VoyteckPL/gas-meter-arduino/gas_meter_app/README.md

# Energia Gazomierz (aplikacja / dodatek Home Assistant)

Panel w pasku bocznym dla gazomierza na baterii (ESP32): odczyty, historia, bateria z prognozą żywotności,
powiadomienia, ustawienia i tryb serwisowy. Rozmawia z gazomierzem przez MQTT.

Instalacja i opis w `DOCS.md`.
