VoyteckPL/gas-meter-arduino/docs/images/ha-panel-mockup.png

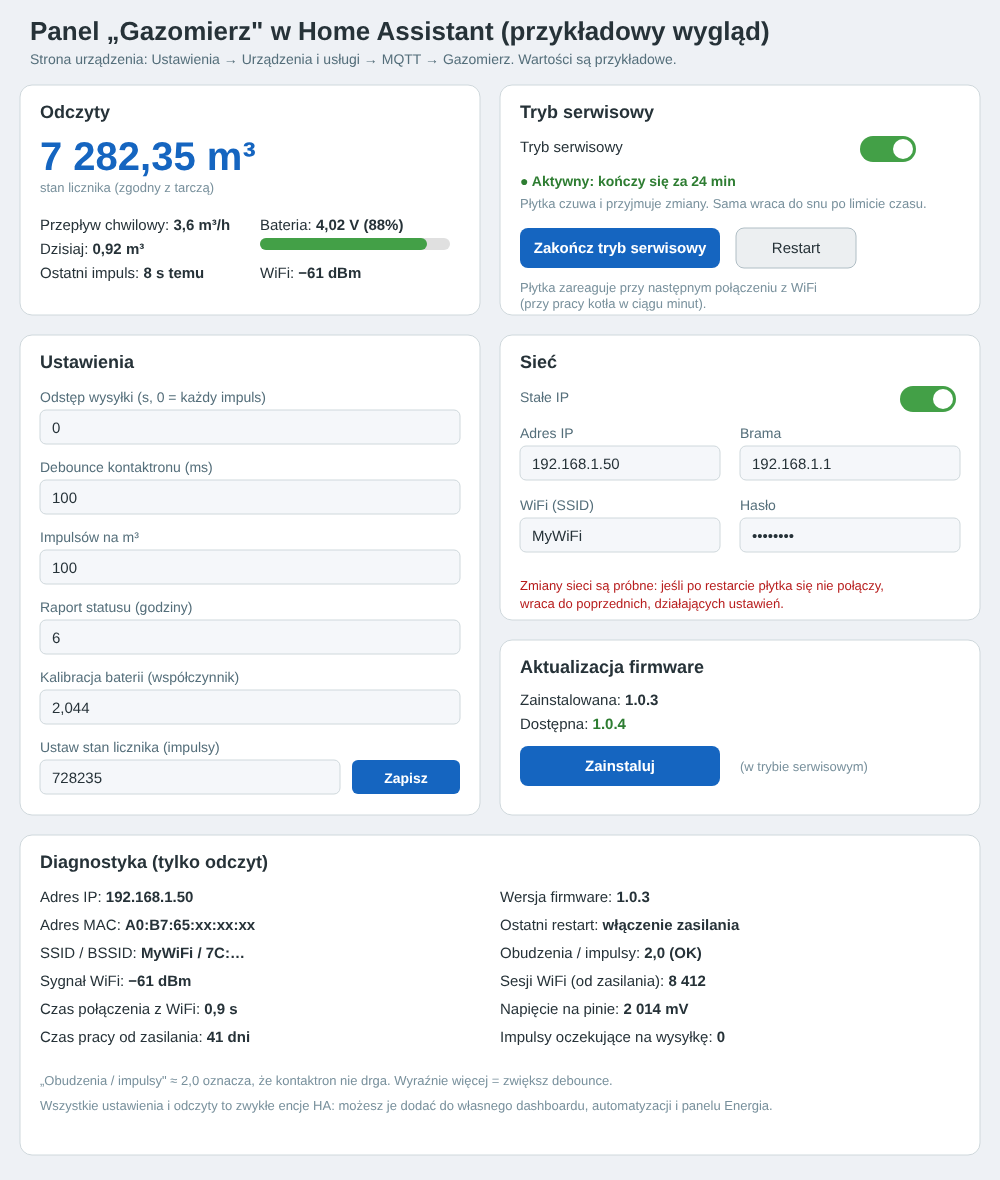
docs/images/ha-panel-mockup.png
