VoyteckPL/gas-meter-arduino/docs/images/reed-pullup.png

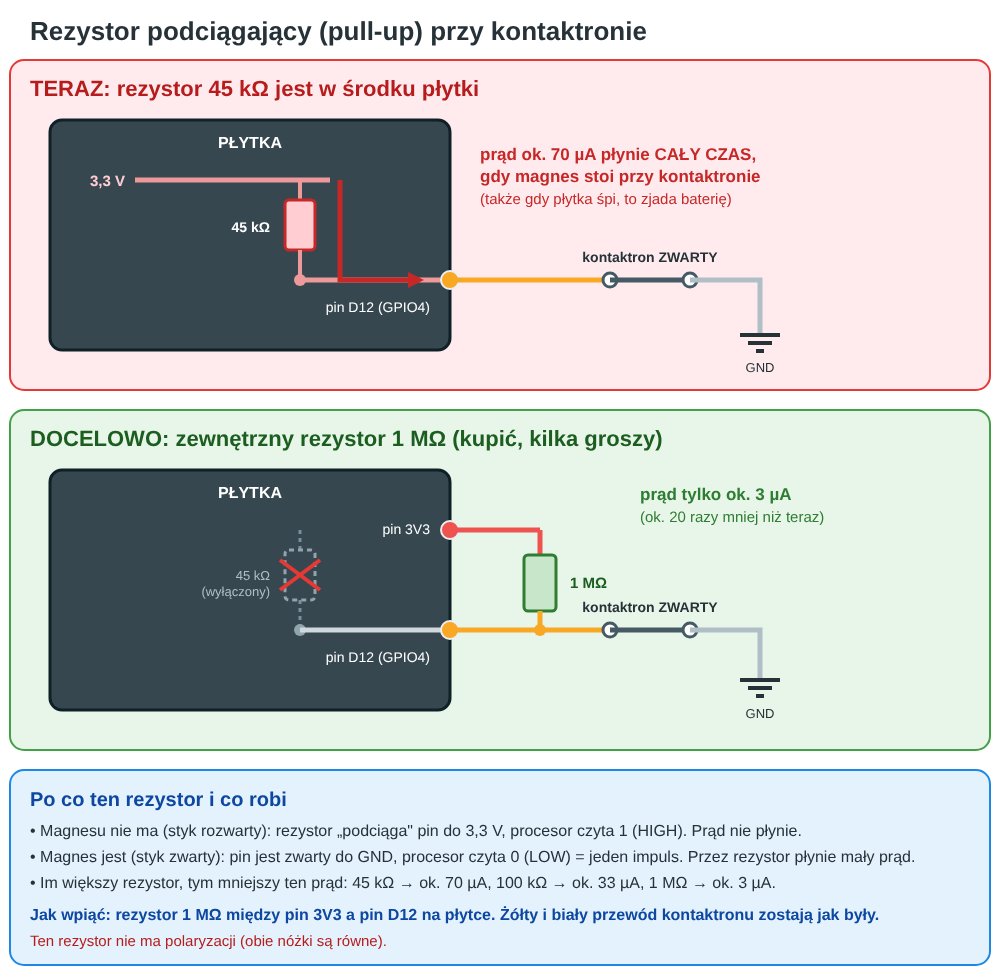
docs/images/reed-pullup.png
