VoyteckPL/gas-meter-arduino/docs/images/wiring-wago.png

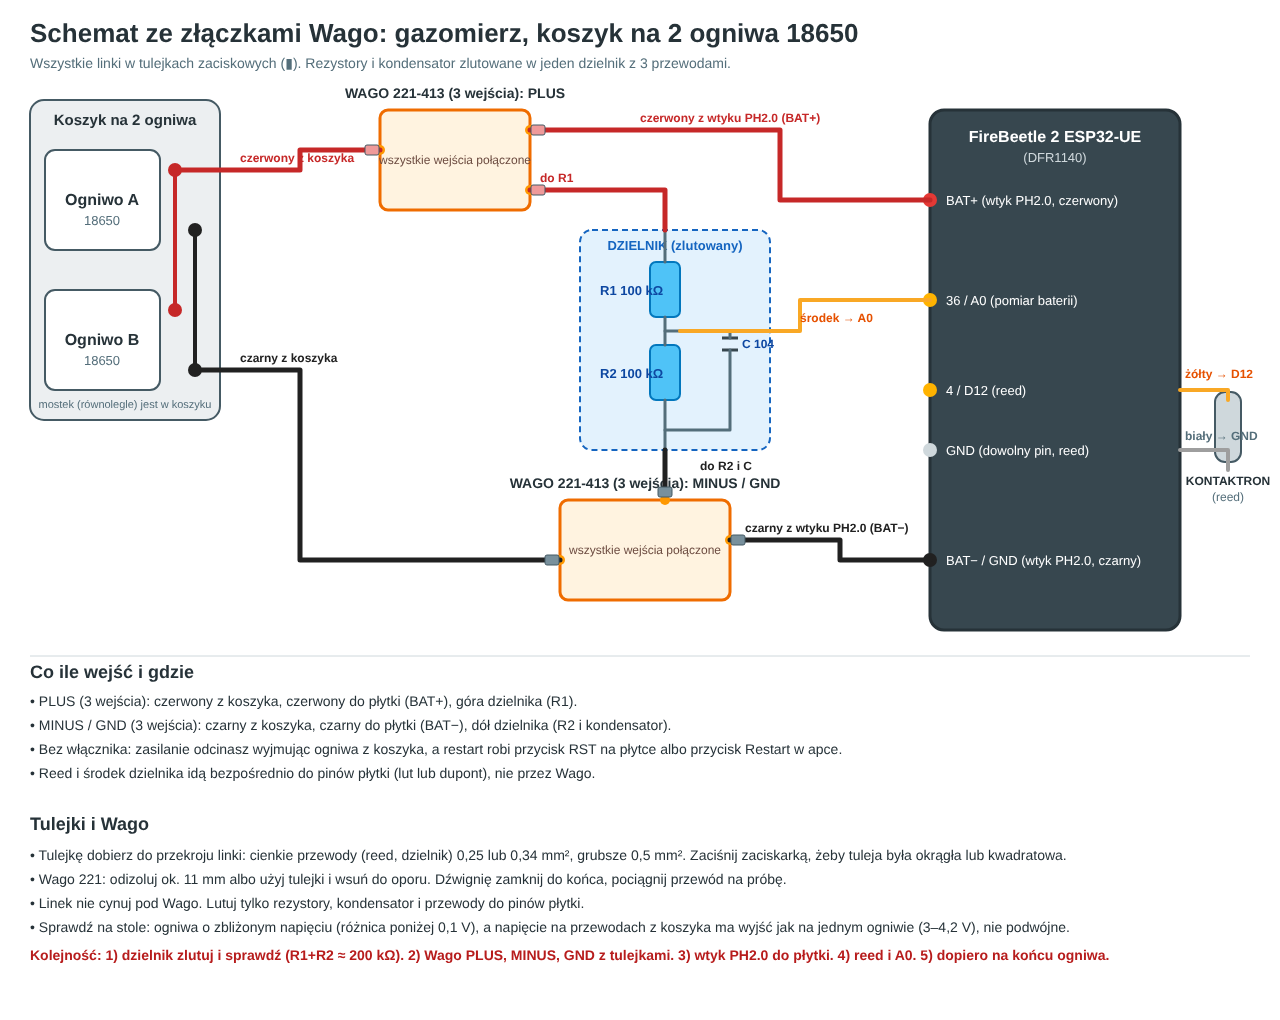
docs/images/wiring-wago.png
