VoyteckPL/gas-meter-arduino/docs/images/wiring.png

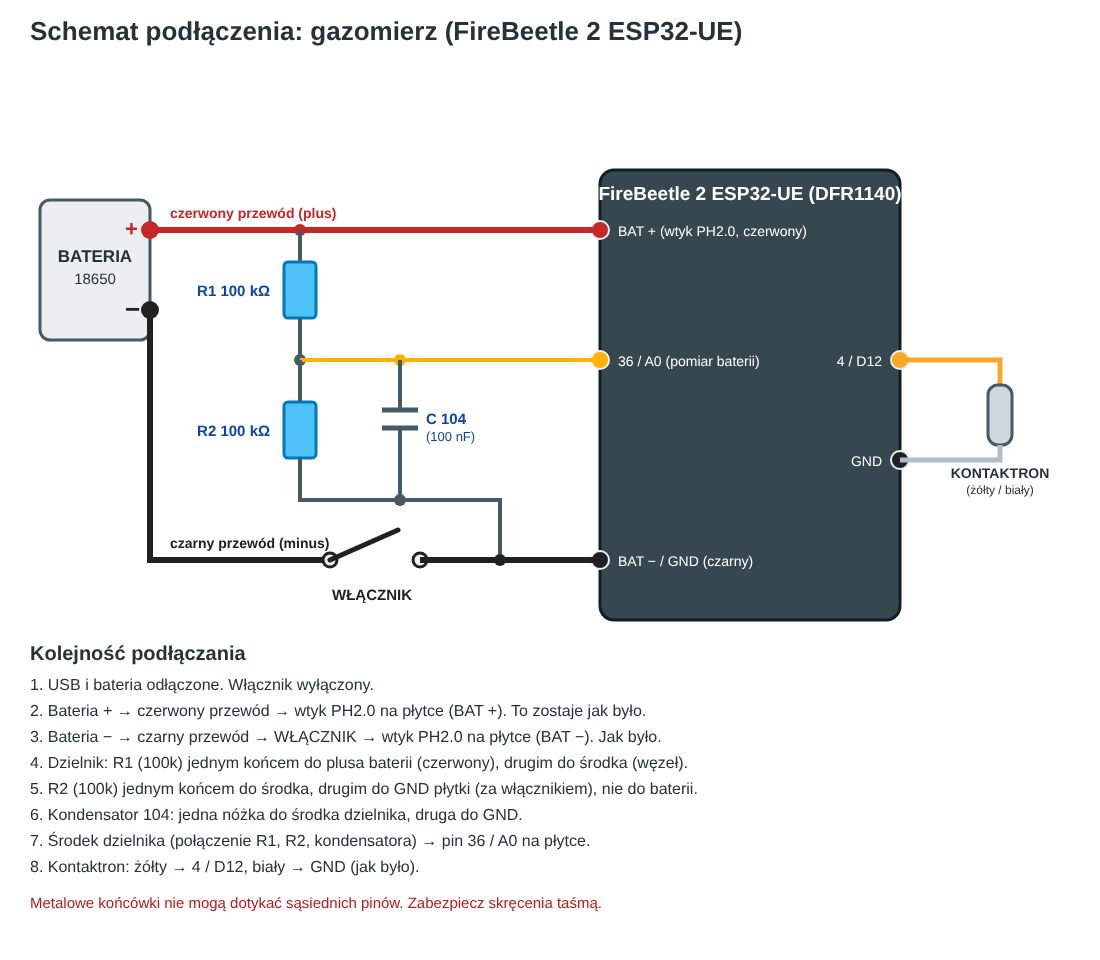
docs/images/wiring.png
