VoyteckPL/gas-meter-arduino/gas_meter_app/CHANGELOG.md

# Changelog

## 0.48.1

* Import statystyk gazu i kosztów (`recorder/import_statistics`) wysyła teraz `mean_type` i `unit_class`. Bez tego HA Core 2026.11 przestaje przyjmować takie importy (historia gazu, podział CWU/ogrzewanie, koszty), a ostrzeżenie w logu HA znika.

## 0.48.0

* Licznik od wymiany baterii. Domyślna data to 29.10.2026 16:40 (opcja „Data wymiany baterii”), zmienisz ją też w zakładce Bateria (data i przycisk „Wymieniłem teraz”).
* Przegląd: nowy kafelek „Od wymiany”: dni pracy, zużycie z ogniw (%) i gaz od wymiany.
* Zakładka Bateria: karta „Od wymiany baterii” z datą włożenia, dniami, energią z ogniw (mAh i %, model z czasu pracy gazomierza), gazem w m³ i impulsach, sesjami WiFi i napięciem na starcie oraz teraz.

## 0.47.3

* Kolory pracy pieca są takie same wszędzie: plakietka stanu, historia „Piec” i tarcza ogrzewania mają teraz kolory z wykresu (ogrzewanie czerwono-pomarańczowe, ciepła woda niebieska, wybieg pompy jasnopomarańczowy).

## 0.47.2

* Wykresy gazu: wybieg pompy jest jasnym, żółtawo-pomarańczowym pasem (ogrzewanie zostaje czerwono-pomarańczowe, ciepła woda niebieska).

## 0.47.1

* Zakładka Piec: gdy termostat ogrzewania zgłasza stan „chłodzi” (cooling) albo „circulating”, to jest wybieg pompy. Tarcza robi się fioletowa, z ikoną pompy, pigułką „Wybieg pompy” i opisem, że piec nie spala gazu. Wcześniej wyglądała jak zwykłe ogrzewanie albo pokazywała „Chłodzi”.

## 0.47.0

* Wykresy: wartość pod palcem (data i stan) pokazuje się w linii legendy nad wykresem, a nie w białym dymku nad danymi. Wykres nic już nie zasłania. Wykresy bez legendy zostają przy dymku.

## 0.46.3

* Wykresy gazu: wyraźniejsze kolory pracy pieca (mocniejsze pasy i gruby pasek u dołu). Wybieg pompy ma własny fioletowy kolor i pozycję w legendzie, zamiast szarego „Inne”.

## 0.46.2

* Wykresy: dymek ze stanem trafia do tej połowy wykresu, w której nie ma linii (odczyt wysoko: dymek na dole, i odwrotnie), więc nie zasłania danych. Jest też lekko przezroczysty.

## 0.46.1

* Wykresy przy dużym powiększeniu: linia sprzed widocznego fragmentu nie jest już ucinana u dołu (oś Y obejmuje poziom, z którym linia wchodzi w widok), etykiety osi z długimi liczbami (7301.485) mają tyle miejsca, ile potrzebują, a dymek na wykresie licznika pokazuje stan w miejscu palca, zamiast skakać do odczytu poza widokiem.

## 0.46.0

* Obsługa firmware 0.4.7: impulsy, które dotarły razem po nieudanej sesji, trafiają na wykres w momentach, w których je policzono (gazomierz wysyła, ile sekund temu był każdy z nich). Koniec ze skokami o kilka impulsów.
* Nowa encja diagnostyczna „Sesje uratowane drugą próbą” (retry_ok); w zakładce Sieć przy nieudanych sesjach i w eksporcie diagnostyki.

## 0.45.1

* Poprawka: przesuwanie i powiększanie wykresów przestawało działać, gdy zgubił się koniec jednego dotyku (np. apka przeszła w tło albo dopiero się uruchamiała). Wykres pamiętał „zawieszony” palec i każdy kolejny dotyk brał za szczypanie. Teraz pierwszy palec zawsze zaczyna od czysta, a po powrocie do apki wszystkie gesty są czyszczone.
* Przesuwanie zakładek palcem: niedokończony gest jest zapominany po powrocie do apki, a ukryte okno nie blokuje przesuwania. Po powrocie do apki strona nie zostaje też zablokowana bez przewijania ani w połowie animacji zakładki.

## 0.45.0

* Przegląd: nowy kafelek „Na zewnątrz” obok „Ostatni odczyt”: temperatura na zewnątrz i pogoda (pochmurno, deszcz…) z Home Assistanta, kolor zależny od temperatury. Źródło w nowej opcji „Temperatura na zewnątrz” (czujnik albo encja pogody); puste = pierwsza encja pogody z HA.

## 0.44.3

* Historia pieca na Przeglądzie ma krótki tytuł „Piec”.

## 0.44.2

* Szczegóły termostatu: okresy grzania, zapłony, gaz i koszt liczone ze stanu pieca (tak jak historia na Przeglądzie), a nie z „hvac_action” termostatu, które w Ariston nie pokrywa się z pracą palnika (stąd 0,00 m³ na nagrzanie). Temperatury dalej z termostatu. Gdy historia stanu pieca jest krótsza niż wybrany zakres, kafelek mówi, od kiedy są dane.

## 0.44.1

* Poprawka: od 0.42.1 wykres licznika na Przeglądzie nie rysował się przy pierwszym otwarciu apki (brakujące tłumaczenie zakładki „Piec” przerywało budowanie strony). Brak tłumaczenia nie zatrzymuje już strony, a błąd odświeżania trafia do konsoli przeglądarki.

## 0.44.0

* Zakładka Piec: stuknięcie w tarczę otwiera szczegóły termostatu (24 godz., 7 dni, 30 dni) z historii Home Assistanta:
  * wykres temperatury zmierzonej i ustawionej, z pasami pokazującymi, kiedy palnik grzał;
  * podsumowanie: ile palnik pracował, ile zapłonów, ile gazu i ile zł (z gazomierza);
  * ciepła woda: średnie nagrzanie zasobnika (czas, o ile stopni, m³ i zł) i jak szybko woda stygnie bez grzania;
  * ogrzewanie: taktowanie (krótkie zapłony poniżej 2 min) i średni czas grzania;
  * szybkie nastawy jednym stuknięciem (19–23° dla ogrzewania, 45–60° dla wody).

## 0.43.1

* Zakładka Piec: ciepła woda rozpoznawana także wtedy, gdy jest encją climate (jak w Ariston): po nazwie albo po zakresie temperatur od ok. 30°. Ogrzewanie zawsze na górze, ciepła woda pod nim, w swoich kolorach i z przyciskami „Włączona / Wyłączona”.

## 0.43.0

* Zakładka Piec w nowym wyglądzie. Ogrzewanie ma zawsze ciepłe kolory (pomarańcz → czerwień), ciepła woda zimne (turkus → błękit), niezależnie od tego, co piec robi.
* Każda tarcza ma nagłówek z ikoną, stan w pigułce (Grzeje, Bezczynny, Wybieg pompy, Wyłączone; świecąca kropka, gdy piec pracuje), łuk z gradientem i podziałką, dużą zmierzoną temperaturę i „cel” pod spodem. Tryb przełącza się przyciskiem z napisami (Grzanie / Wyłączone, Włączona / Wyłączona). Wyłączona tarcza szarzeje.

## 0.42.1

* Sterowanie piecem w osobnej zakładce „Piec” (zaraz po Przeglądzie), tarcze jedna pod drugą. Gdy apka nie znajdzie termostatów, zakładka mówi, co wpisać w opcjach.

## 0.42.0

* Nowa karta „Sterowanie piecem” na Przeglądzie: tarcze ogrzewania i ciepłej wody jak w HA Views. Widać zmierzoną i ustawioną temperaturę, co robi piec (grzeje, bezczynny, wybieg pompy, wyłączony) i ciśnienie. Przyciski −/+ zmieniają temperaturę (wysyłana po chwili, gdy przestaniesz klikać), przyciski trybu włączają i wyłączają (wyłączenie z potwierdzeniem).
* Termostaty apka znajduje sama na urządzeniu encji stanu pieca (climate i water_heater, plus czujnik ciśnienia w barach). Można je wskazać ręcznie w nowej opcji „Termostaty pieca”.

## 0.41.1

* Historia pieca odświeża się na żywo razem z wykresem (co 10 s zamiast co minutę).

## 0.41.0

* Historia pieca w czterech widokach do wyboru (zapamiętywany w przeglądarce): Oś czasu, Godziny, Sesje, Tory. Wszystkie mają jedną kolumnę, najnowsze na górze.
* Krótkie zapłony z wybiegiem pompy (mniej niż 5 min przerwy) łączą się w jedną sesję; seria krótkich zapłonów jest opisana jako „taktowanie”.
* Łączny koszt obok tytułu karty (chowany przyciskiem „zł”).

## 0.40.1

* Stan pieca przy wykresie zmienia się w ciągu kilku sekund (apka pyta HA co 3 s zamiast co 20 s), bez odświeżania strony. Historia pieca przeładowuje się sama przy zmianie trybu.

## 0.40.0

* Koszt na wykresach, wyłączany przyciskiem „zł” (zapamiętywany w przeglądarce): na wykresie licznika pod każdym grzaniem i ciepłą wodą jego koszt oraz linijka „w widoku … m³ · … zł”; w oknie historii stanu licznika te same kwoty i wiersz „Koszt gazu”; w historii pieca kwoty i suma.
* Historia pieca ułożona: każde uruchomienie w równym wierszu z kolumnami (godziny, czas, m³, zł), lista idzie po kolei w dół. Podsumowania trybów w równej siatce.
* Wybieg pompy bez m³ i zł (pompa nie spala gazu; to była końcówka poprzedniego grzania).

## 0.39.0

* Nowa karta „Piec: co chodziło” na Przeglądzie (dziś, 24 godz., 7 dni): każde uruchomienie pieca jako plakietka z godzinami, czasem, zużytymi m³ i kosztem w zł. Na górze podsumowanie każdego trybu i łączna kwota, pod nim pasek czasu.
* Koszt liczony samą ceną gazu z faktur (zł/kWh × kWh/m³), bez opłat stałych, bo te płaci się i tak.
* Kliknięcie plakietki stanu pieca przy wykresie przewija do historii.

## 0.38.2

* Stan pieca: „circulating” to wybieg pompy, z ikoną pompy.

## 0.38.1

* Wykres licznika: bez stanu licznika przy kropce „teraz” (jest w pasku odczytów).
* Obok tytułu wykresu: co teraz robi piec (Ogrzewanie, Ciepła woda, Wybieg pompy, spoczynek), od kiedy i jak długo. Stan „cooling” z encji HVAC jest pokazywany jako wybieg pompy. Ikona świeci, gdy piec pracuje.

## 0.38.0

* Bateria, Sieć i OTA w nowym stylu: u góry pasek kafelków, niżej karty na całą szerokość, szczegóły i ustawienia zwinięte na dole.
* Bateria: kafelki naładowanie, pojemność, wystarczy na, naładuj do, średni prąd, sesje WiFi na dobę. Prognoza żywotności i tabela miesięcy obok siebie, „Na co idzie energia” obok „A gdyby…”. Statystyki dla nerdów i powiadomienia zwinięte. Dane testu rozładowania są w karcie wykresu.
* Sieć: sygnał, czas łączenia, nieudane sesje (z odsetkiem), adres IP, punkt dostępu i MAC.
* OTA: firmware, czas pracy, impulsy i obudzenia na górze; ustawianie stanu licznika i diagnostyka zwinięte.

## 0.37.0

* Zakładka Zużycie uporządkowana: u góry pasek odczytów jak na Przeglądzie (zużycie, koszty, prognoza), niżej wykresy na całą szerokość, bez pustych miejsc.
* Usunięte: tabela prognozy na 6 miesięcy, wykres „im zimniej, tym więcej gazu” i tabela „Czy dom jest oszczędniejszy?”. Krótsze opisy przy wykresach.
* „Rocznie” jest teraz w karcie „Porównanie lat”, a profil sezonowy w dwóch kolumnach.
* Faktury z eBOK, Orlen, Panel Energia (koszty wstecz i podział pieca) i lokalizacja pogody są zwinięte na dole w sekcji „Dane i ustawienia”.
* Karta pieca znika, gdy nie ma ustawionej encji pieca.

## 0.36.0

* Nowy pasek odczytów na Przeglądzie: wszystko w jednym rzędzie, w dwóch grupach (gaz | gazomierz), z większymi ikonami.
* Nowy kafelek „Ostatni pobór”: kiedy gaz ostatnio płynął (ostatni przyrost licznika). „Ostatni odczyt” to osobno ostatnie dane z gazomierza.
* Kolory mówią o stanie: przepływ pulsuje, gdy gaz płynie; bateria, sygnał WiFi i świeżość odczytu zmieniają kolor przy problemie.
* Usunięta podpowiedź „Kliknij wartość…” (kafelki nadal otwierają historię).

## 0.35.6

* Wykres licznika nie znika już („Brak danych”) po dłuższej nieaktywności apki. Gdy telefon uśpił stronę i zapytanie o dane przepadło, wykres zostaje ostatni znany, a po powrocie do apki odświeża się od razu.

## 0.35.5

* Zakładka OTA: przycisk „Pobierz diagnostykę połączenia”. Plik JSON z ostatnich 48 godzin: nieudane sesje wg etapu, sesje WiFi, czasy, sygnał, stan i przyrosty na godzinę z odsetkiem porażek. Apka zapisuje teraz historię także dla liczników nieudanych sesji (wcześniej tylko HA).

## 0.35.4

* Nowe encje diagnostyczne (firmware 0.4.5): Nieudane sesje – WiFi, połączenie z brokerem, subskrypcja, brak potwierdzenia. Pokazują, na którym etapie zawodzą sesje licznika.

## 0.35.3

* Koszty wstecz: gdy HA po zaimportowanych godzinach zaczął sumę kosztu od zera (panel pokazywał ujemny koszt), przycisk wykrywa spadek sumy i podnosi resztę statystyki o brakującą wartość.

## 0.35.2

* Koszty wstecz działają też, gdy HA nie zapisał jeszcze żadnej godziny kosztu: historia jest wpisywana do ostatniej pełnej godziny.

## 0.35.1

* Koszty wstecz: encja kosztu jest brana z informacji panelu Energia (`energy/info`), a nie zgadywana po nazwie.

## 0.35.0

* Koszty gazu wstecz w panelu Energia (zakładka Zużycie → „Koszty w panelu Energia (wstecz)”). Każda godzina historii przed ustawieniem ceny dostaje zużycie × cena z faktury z tego miesiąca i trafia do tej samej statystyki kosztu, którą HA prowadzi dla Gazomierza; późniejsze godziny są przesunięte o dopisaną sumę, więc suma jest ciągła. „Sprawdź” tylko liczy.

## 0.34.0

* Nowa encja w HA „Przepływ gazu” (m³/h, średnia z ostatnich 15 minut), odświeżana co minutę, więc po wyłączeniu pieca spada do 0.
* Zakładki uporządkowane: Przegląd, Zużycie, Bateria, Sieć, OTA. „Serwis” nazywa się teraz „OTA” i zawiera też kartę „Ustaw stan licznika” (zakładka Ustawienia zniknęła). Zakładka Demo (symulator) usunięta.
* Apka zawsze otwiera się na Przeglądzie.
* Bateria: usunięta karta „Historia baterii z Home Assistant” (import starych statystyk). Prognoza pokazuje trend napięcia dopiero, gdy jest wiarygodny (wcześniej przy kilku dniach danych dawała mylące „80 dni”); bez podwójnej legendy pod wykresem.

## 0.33.1

* Usunięty wygląd „Zachód 3D”. Zostają „Zachód słońca”, „Zmierzch” i „Zmierzch + godziny”. Kto miał wybrany 3D, dostaje „Zachód słońca”.

## 0.33.0

* Przegląd: wykres licznika w kolorach zachodu słońca, do wyboru cztery wyglądy (przyciski w nagłówku karty, wybór jest zapamiętany w przeglądarce): „Zachód słońca” (jasny), „Zmierzch” (ciemny), „Zachód 3D” (wstęga wyciągnięta w głąb) i „Zmierzch + godziny” (dodatkowo słupki m³ w każdej godzinie).
* Płynna krzywa, gdy impulsów jest dużo; po powiększeniu schodki z zaokrąglonymi rogami. Linia z gradientem, blaskiem i cieniem, wypełnienie z połyskiem, gradientowe tło karty.
* Aktualny odczyt to świecąca, pulsująca kropka z wartością w kapsułce. Pasy pieca to kolumny od dołu z ikonami 🔥 (ogrzewanie) i 💧 (ciepła woda); w legendzie „Inne” bez dopisku.

## 0.32.1

* Wykres licznika na Przeglądzie: „teraz” jest w środku, po prawej zostaje miejsce na przyszłość, a linia nie jest już ucięta przy prawej krawędzi. Okno przesuwa się z czasem, dopóki go nie ruszysz. Przyciski zakresów (1 godz. – 7 dni) ustawiają szerokość okna wokół „teraz”.
* Rogi schodków są zaokrąglone, linia wygląda płynniej. Płaski odcinek jest pokazywany na środku wykresu, a nie przy dolnej krawędzi.

## 0.32.0

* Przegląd: jeden wykres, „Licznik gazu”. Linia schodkowa jest narysowana jak wstęga z cieniem, poświatą i jasną krawędzią (bez kropek), pod nią gradient. Wykres jest na żywo: co 10 s przesuwa się razem z czasem i pokazuje ostatni odczyt aż do teraz, dopóki go nie przewiniesz. Można go powiększać i przewijać, a przyciski 1 godz., 6 godz., 24 godz., 48 godz. i 7 dni wracają do „teraz”. Tło dalej pokazuje, co robił piec (ciepła woda, ogrzewanie). Zakładki „Na godzinę” i „Bateria” z tego miejsca zniknęły (są w okienku historii po kliknięciu karty i w zakładce Bateria).

## 0.31.2

* „Ostatnie dane” i alarm o milczącym gazomierzu liczą czas od ostatniej wiadomości z gazomierza, a nie od wartości, które apka sama publikuje co 10 minut (prognozy, szacunek baterii, procent WiFi). Wcześniej karta pokazywała „kilka minut temu” mimo ostatniego odczytu sprzed godzin, a alarm „gazomierz milczy” mógł się nigdy nie włączyć.

## 0.31.1

* Nowa encja w HA „WiFi sygnał (%)”: apka przelicza RSSI gazomierza na procenty (−90 dBm i gorzej to 0 %, −30 dBm i lepiej to 100 %) i publikuje je od razu po każdym odczycie RSSI.

## 0.31.0

* Porządki po uporządkowaniu historii gazu w HA. Usunięte z apki: scalanie historii gazu z kilku encji, korekty dni i miesięcy, karta „Start od montażu”, eksport i wczytanie pliku, wysyłanie statystyki „Gazomierz (z historią)” do panelu Energia oraz encja „Licznik gazu (z historią)”. Historia gazu żyje teraz w statystykach samej encji „Gazomierz”.
* Przy starcie apka usuwa z HA statystykę „Gazomierz (z historią)” z poprzednich wersji i encję „Licznik gazu (z historią)”.
* Zakładka „Historia” zniknęła. Karta „Historia baterii z Home Assistant” jest w zakładce Bateria. Statystyki pieca (ciepła woda, ogrzewanie, reszta) dla panelu Energia zostają.

## 0.30.18

* Wczytanie gotowej historii działa w tle i wysyła wszystkie paczki jednym połączeniem z HA. Wcześniej długa historia (ponad 60 tys. godzin) była przerywana przez limit czasu zapytania i w statystykach lądowała tylko jej część (u Ciebie do marca 2025). Strona pokazuje postęp i wynik.

## 0.30.17

* Historia → „Wczytaj gotową historię”: zapisuje przygotowany plik godzinowych odczytów w statystykach encji gazu apki (czyści jej dotychczasowe statystyki, godziny po końcu pliku bierze z samej encji i liczy od nowa sumę, więc encja rośnie dalej od końca historii; pojedyncze błędne odczyty pomija). „Sprawdź plik” pokazuje, co zostanie zapisane, bez zapisywania.
* Urządzenie w HA nazywa się „Gazomierz”, a główny czujnik gazu nie ma własnej nazwy, więc też jest „Gazomierz”. Identyfikator encji zostaje, zmieniasz go w HA.

## 0.30.16

* Eksport statystyk zawiera też zużycie miesięczne z faktur (sam miesiąc i m³, bez numerów), do dopasowania historii do faktur.

## 0.30.15

* Historia → „Eksport statystyk”: zapisuje do pliku JSON godzinowe statystyki wybranych encji (stan i suma), także encji, których już nie ma w HA. Do jednorazowego uporządkowania historii gazu.

## 0.30.14

* Start od montażu poprawia skoki licznika w statystykach obu encji gazu apki: „Cubic meters” i „Licznik gazu (z historią)” (ta druga bywa źródłem w panelu Energia).

## 0.30.13

* Przegląd: główny wykres to teraz interaktywny wykres stanu licznika z ostatnich 48 h z kolorowym tłem pieca (ciepła woda / ogrzewanie), z przewijaniem i powiększaniem. Zakładki: Licznik, Na godzinę (też z kolorami), Bateria.
* Start od montażu: osobny wybór dla licznika (razem z przepływem i zużyciem na godzinę), sygnału WiFi i diagnostyki oraz baterii.

## 0.30.12

* Wykresy gazu w okienku historii (stan licznika, przepływ, zużycie na godzinę) mają kolorowe tło według tego, co robił piec: niebieskie ciepła woda, pomarańczowe ogrzewanie, szare inne. Działa z encją pieca ustawioną w opcjach (`boiler_entity`).

## 0.30.11

* Historia → „Start od montażu”: usuwa z apki odczyty licznika i diagnostykę sprzed montażu (domyślnie od ostatniego ustawienia stanu licznika) i wyjmuje ze statystyk encji „Cubic meters” w Home Assistant skoki po ustawieniu licznika (`recorder/adjust_sum_statistics`), żeby panel Energia nie pokazał ich jako zużycia. Historię baterii zostawia, chyba że zaznaczysz inaczej. Można uruchamiać wielokrotnie.

## 0.30.10

* Przegląd: „Dzisiaj”, „Przepływ” i wykres zużycia na godzinę pomijają skok licznika po jego ustawieniu (wcześniej ustawienie stanu z tarczy pokazywało się jako tysiące m³ zużycia). Ten sam filtr co w statystykach: krok większy niż możliwy przepływ gazomierza G4 nie jest gazem.

## 0.30.9

* Nowe encje diagnostyczne urządzenia „Gas meter” w HA (z historią i wykresami): ostatnia sesja WiFi, czas łączenia z WiFi, czas pracy z WiFi i bez, obudzenia, sesje WiFi, zawieszenia, DHCP. Wartości przychodzą ze statusem gazomierza.

## 0.30.8

* Model baterii korzysta ze zmierzonego czasu pracy gazomierza (firmware 0.4.4+: `awake_wifi_s`, `awake_other_s`), zamiast stałego kosztu sesji. Wliczają się w to dłuższe łączenie przy słabym WiFi, statusy i nieudane sesje.
* Bateria → Statystyki dla nerdów: czas pracy na sesję WiFi i czas pracy na dobę. Diagnostyka: czas ostatniej sesji WiFi.

## 0.30.7

* Poprawka w dzienniku aktualizacji: ostrzeżenie „gazomierz zgłosił się, ale nie zaczął pobierać pliku” pojawiało się zaraz po uzbrojeniu, bo apka brała pod uwagę sesję z poprzedniej aktualizacji. Teraz liczy się tylko sesja po uzbrojeniu.

## 0.30.6

* Ustawienie stanu licznika wysyła też licznik, który apka widziała w chwili zapisu. Firmware 0.4.1 dolicza impulsy od tej chwili, więc impuls, który obudził gazomierz, już nie przepada (wcześniej licznik zostawał o 1 w tyle za tarczą). Starszy firmware czyta samą wartość jak dotąd.
* Czekające polecenie stanu licznika jest pokazywane w m³.

## 0.30.5

* Nowa zakładka „Historia”: przeniesiono do niej karty historii gazu i historii baterii z Home Assistanta (zakładka „Serwis” ma teraz aktualizację firmware i diagnostykę).
* Znaczek przy zakładce „Ustawienia” liczy tylko polecenie stanu licznika. Stare, zapamiętane na brokerze polecenia `set/...` z usuniętych ustawień apka sama kasuje (firmware ich nie czyta, więc wisiały na zawsze).
* Poprawiony opis przy stanie licznika: gazomierz przyjmuje go przy najbliższym połączeniu z WiFi, bez restartu.

## 0.30.4

* Apka nie publikuje ponownie polecenia aktualizacji, które gazomierz już obsłużył i sam usunął z brokera (wcześniej w dzienniku pojawiało się wtedy zbędne „opublikowano je ponownie”).

## 0.30.3

* Ponowna instalacja tej samej wersji kończy się też wtedy, gdy gazomierz zgłosi się po instalacji, a polecenie zniknie z brokera. Firmware 0.3.8 wysyła potwierdzenie aktualizacji z QoS 1 (wcześniej mogło zginąć przy zamknięciu połączenia, przez co polecenie zostawało na brokerze) i pamięta zainstalowane polecenie, więc to samo polecenie nie zainstaluje się drugi raz.

## 0.30.2

* Można zainstalować ponownie tę samą wersję bez kompilowania: gdy plik ma wersję, którą gazomierz już ma, pojawia się przycisk „Zainstaluj ponownie tę samą wersję”. Apka wysyła wtedy polecenie z numerowaną wersją (np. 0.3.6.1), gazomierz pobiera ten sam plik, instaluje go i potwierdza. Przydatne do testów aktualizacji, wycofania i odbioru polecenia.

## 0.30.1

* Karta aktualizacji pokazuje, czy polecenie aktualizacji jest na brokerze MQTT. Jeśli uzbrojone polecenie zniknie z brokera, apka sama publikuje je ponownie i zapisuje to w dzienniku.

## 0.30.0

* Firmware 0.3.5: limit czuwania 150 s (zawieszony gazomierz sam się restartuje, a licznik zostaje w pamięci RTC; zawieszenie świeżo zainstalowanej wersji liczy się jak awaria i prowadzi do powrotu do poprzedniej), powrót na DHCP po 3 nieudanych sesjach ze stałym IP, status (bateria, sygnał WiFi, diagnostyka) co godzinę zamiast co 6 godzin. W diagnostyce jest nowa pozycja „Zawieszenia”.
* Model baterii liczy teraz 24 sesje statusowe na dobę zamiast 4, więc prognoza uwzględnia godzinny status.

## 0.29.3

* Uporządkowana karta aktualizacji firmware: jeden przycisk „Wybierz plik firmware” wgrywa plik od razu po wyborze (bez osobnego „Wgraj plik”), w jednym wierszu są plik z wersją i akcje („Zaktualizuj przy najbliższym impulsie”, „Zmień plik”, „Usuń plik”), a po uzbrojeniu zostaje tylko „Anuluj aktualizację”. Stan gazomierza i uzbrojenia jest w nagłówku karty. Dziennik i instrukcja są zwijane, dziennik otwiera się sam, gdy aktualizacja jest uzbrojona. Kroki aktualizacji znikają po 10 minutach od jej zakończenia.

## 0.29.2

* Dziennik aktualizacji podpowiada, jak odczytać raport gazomierza: „request accepted” (firmware 0.3.3 i nowszy) znaczy, że polecenie dotarło i zostało przyjęte.

## 0.29.1

* Karta aktualizacji ma „Dziennik aktualizacji”: kolejne kroki z godziną (wgranie pliku, uzbrojenie, zgłoszenie się gazomierza, początek i koniec pobierania albo jego przerwanie, raport gazomierza, zmiana wersji, zakończenie). Jeśli gazomierz zgłosi się, a po 25 sekundach nie zacznie pobierać, dziennik wypisze możliwe przyczyny. Dziennik zapisuje się w apce i nie znika po restarcie.

## 0.29.0

* Aktualizacja firmware ma pasek postępu i kroki: plik wgrany, uzbrojona, gazomierz się zgłosił, pobieranie pliku z procentami (apka liczy bajty wysłane do gazomierza), instalacja i potwierdzenie nowej wersji albo problem z raportu gazomierza. Podczas aktualizacji karta odświeża się co 2 sekundy.

## 0.28.2

* Karta aktualizacji firmware pokazuje wprost, czy aktualizacja jest uzbrojona (czeka na impuls), czy nie (gazomierz pracuje normalnie).

## 0.28.1

* Historia gazu: na liście encji do scalania nie ma już statystyk, które apka sama tworzy (podział pieca, encja „Licznik gazu (z historią)”), żeby nie dało się ich wybrać przez pomyłkę.

## 0.28.0

* Aktualizacja firmware gazomierza przez WiFi (OTA), jednorazowa i bez trybu serwisowego. W zakładce Serwis wgrywasz plik `.bin`, klikasz „Zaktualizuj przy najbliższym impulsie”, a gazomierz przy najbliższym impulsie gazu pobiera plik, instaluje go i restartuje się. Polecenie jest podpisane (HMAC-SHA256, opcja `ota_key` = `OTA_KEY` w secrets.h), plik jest dostępny tylko, gdy aktualizacja jest uzbrojona, pod losowym adresem na porcie 8098. Gazomierz zapisuje licznik przed aktualizacją, sprawdza MD5, a gdy nowy firmware nie działa (2 awarie albo 6 nieudanych sesji), wraca sam do poprzedniego. Wymaga firmware 0.3.0 wgranego raz kablem. Opis: docs/ota.md.
* Nowe opcje: `ota_key` i `ota_host` (adres IP Home Assistanta w sieci, puste = wykryj automatycznie).

## 0.27.0

* Historia gazu: odczyty encji są teraz brane z pola „suma” statystyk (liczy dalej mimo zerowania licznika źródła), a z pola „stan” tylko gdy suma nie jest dostępna. Przy każdej encji na liście widać, z którego pola czytała apka, ile ma godzin, przerw w danych i odrzuconych spadków licznika.
* Przerwy w danych (brak odczytów dłużej niż 36 godzin, także między dwiema encjami) są wypisane z datami i oznaczone jako „luka w danych”. Dni w przerwach trafiają na listę podejrzanych i można je uzupełnić typowym zużyciem razem z pustymi dniami.
* Nowa sekcja „Wyrównanie do faktur”: miesiące z historii obok zużycia z faktur, przycisk „Wyrównaj” dla jednego miesiąca albo wszystkich, które różnią się o więcej niż 3 %. Dni miesiąca są skalowane do sumy z faktury z zachowaniem rozkładu zużycia, ręczne poprawki dni zostają. Wyrównanie można cofnąć. Działa też dla miesięcy bez danych (zużycie z faktury rozkłada się równo).
* Historia o innej skali niż licznik (np. suma z encji zamiast stanu) jest przesuwana do pierwszego odczytu gazomierza, więc nie ma skoku na styku.

## 0.26.1

* Po wgraniu historii do encji apka pyta Home Assistanta, czy statystyki encji są widoczne, i pokazuje ich liczbę, początek i sumę. Jeśli HA ich nie widzi, pokazuje błąd zamiast sukcesu. Karta wyjaśnia też, gdzie szukać historii: okno encji pokazuje tylko ostatnią dobę, a długą historię widać w panelu Energia, w karcie „Wykres statystyk” i w Narzędzia deweloperskie → Statystyki.

## 0.26.0

* Historia gazu: przycisk „Utwórz encję i wgraj historię” tworzy w Home Assistancie prawdziwą encję „Licznik gazu (z historią)” (jest w rejestrze encji, w urządzeniu Gas meter) i wgrywa do jej statystyk całą scaloną i poprawioną historię. Tę jedną encję wskaż w panelu Energia zamiast starych. Po poprawkach kliknij ponownie, historia encji zostanie zastąpiona. Statystyka zewnętrzna „Gazomierz (z historią)” zostaje jako druga opcja.
* Kliknięcie słupka na wykresie historii otwiera poprawkę tego dnia pod wykresem: wpisujesz zużycie albo wybierasz „Typowe”, możesz też cofnąć poprawkę lub uznać dzień za prawdziwy.
* Jeden palec przesuwany w bok po wykresie przewija wykres (pionowy ruch dalej przewija stronę). Podpowiedź na wykresie historii pokazuje jeden dzień zamiast najbliższych dni z każdego koloru.

## 0.25.0

* Historia gazu: przycisk „Uzupełnij puste dni typowym zużyciem” ustawia wszystkie dni bez zużycia w środku sezonu (na przykład przerwę między dwiema encjami) na typowe zużycie z sąsiednich dni. Wiele pustych dni z rzędu nie zaniża już „typowego” poziomu.
* Poprawki na wszystkich naraz: „Popraw skoki na typowe”, „Popraw wszystkie”, „Uznaj wszystkie za prawdziwe”, a także zaznaczanie dni pól wyboru z przyciskami „Popraw zaznaczone” i „Uznaj zaznaczone”. Przed zmianą apka pokazuje liczbę dni i o ile zmieni się zużycie. „Cofnij wszystkie poprawki” przywraca dane z Home Assistanta.

## 0.24.1

* Przesunięcie palcem w bok po wykresie nie przełącza już zakładki: wykres sam się przewija. Dotyczy wszystkich przewijanych wykresów.
* Historia gazu: poprawka dnia zrobiona na samym podglądzie (przed „Wczytaj i scal”) nie kasuje już podglądu. Podgląd zostaje, a poprawka jest od razu widoczna.

## 0.24.0

* Nowa karta „Historia gazu z Home Assistanta” w zakładce Serwis: wybierasz kilka encji ze statystykami gazu (np. starą od 2019 i nową), a apka składa z nich jedną historię. Najnowsza encja jest wzorcem, starsze są przesuwane tak, żeby odczyty się zszyły; gdy encje się pokrywają, wygrywa nowsza. Karta pokazuje wykres zużycia na dobę w kolorach encji, informację o każdym zszyciu (przerwa, przesunięcie) i listę podejrzanych dni (nagły skok, ponad 6 m³ w godzinę, brak zużycia w środku sezonu).
* Podejrzany dzień możesz poprawić (ustawić zużycie, domyślnie typowe z sąsiednich dni), uznać za prawdziwy albo cofnąć poprawkę. Można też ustawić zużycie dowolnego dnia. Poprawki są zapisane w apce, odczyty liczone są od najnowszego, więc stan licznika dziś się nie zmienia.
* Przycisk „Wyślij scaloną historię do panelu Energia” wysyła wynik jako jedną statystykę „Gazomierz (z historią)”. Wskaż ją w panelu Energia zamiast starych encji, żeby nie liczyć podwójnie. Po każdej poprawce wyślij ją jeszcze raz.
* Stara karta historii służy już tylko do napięcia baterii.

## 0.23.1

* Z apki usunięte wszystkie ustawienia, których firmware nie obsługuje: tryb serwisowy, restart i aktualizacja gazomierza, zmiana parametrów (odstęp wysyłki, debounce, kalibracja baterii i inne) oraz edycja sieci. Gazomierz odbiera z brokera tylko stan licznika, więc reszta tylko wisiała jako „czeka na gazomierz”. Zakładka Ustawienia ma teraz ustawianie stanu licznika, Sieć pokazuje tylko podgląd, a Serwis import historii z Home Assistanta i diagnostykę.

## 0.23.0

* Karta pieca ma widok „Miesiące i sezony”: gaz na ciepłą wodę, ogrzewanie oraz postój i resztę w każdym miesiącu, z udziałem wody w procentach. Podział dni apka zapisuje na stałe, więc historia rośnie, choć Home Assistant trzyma stany pieca tylko około 10 dni.
* Trzy nowe statystyki do panelu Energia: „Gaz – ciepła woda”, „Gaz – ogrzewanie” i „Gaz – postój i reszta”. Razem dają zużycie gazomierza. Przycisk „Wyślij do panelu Energia” wysyła je od pierwszej znanej godziny, potem nowe godziny dopisują się co godzinę.

## 0.22.0

* Nowa karta „Piec: ciepła woda i ogrzewanie” w zakładce Zużycie. Apka czyta stan pieca z encji z Home Assistanta (domyślnie `sensor.ariston_genus_one_status_kotla`, opcja `boiler_entity`) i dzieli gaz na ciepłą wodę, ogrzewanie oraz postój i resztę. Gaz między zmianami stanu bierze z odczytów gazomierza, więc każdy tryb dostaje tyle, ile zużył w swoim czasie trwania. Karta pokazuje słupki na dobę, liczbę cykli, średni czas, gaz i moc kW.
* Apka tylko czyta stan pieca i zapisuje go u siebie, niczego nie wysyła do pieca. Stany `unknown` i `unavailable` są pomijane. Recorder HA trzyma historię około 10 dni, więc starszych miesięcy nie da się podzielić wstecz.

## 0.21.13

* Wykres baterii: przy widoku dłuższym niż około 5 miesięcy każdy miesiąc ma podpis i podziałkę, rok jest przy styczniu i przy pierwszym podpisie, a co drugi miesiąc ma jasne tło. Przy krótkich zakresach (dni, tygodnie) zostają dotychczasowe podpisy godzin i dni.

## 0.21.12

* Model baterii uwzględnia teraz drugie wybudzenie każdego impulsu (przy rozwarciu kontaktronu, bez WiFi, około 0,35 s). Ma własny słupek „Wybudzenia przy rozwarciu” w podziale zużycia energii i wchodzi też do prognozy z sezonami.

## 0.21.11

* Zakładka Bateria odświeża się od razu, gdy gazomierz wyśle nowe napięcie (np. po włożeniu ogniwa). Wcześniej trzeba było odświeżyć stronę (F5) albo czekać do minuty.

## 0.21.10

* Prognoza baterii działa od pierwszego dnia: dopóki nie ma historii licznika i sesji WiFi, liczba impulsów na dobę jest brana z zużycia gazu w tym miesiącu według faktur. Wcześniej przez pierwsze godziny po starcie (albo po wymianie baterii) prognozy były puste.
* Koszt jednej sesji WiFi w modelu: 0,015 mAh (zmierzone około 0,7 s z kluczem WPA w hex i statycznym IP), wcześniej 0,04 mAh. Domyślnie jedna sesja na impuls, bo firmware wysyła każdy impuls.

## 0.21.9

* Zakładka Bateria pokazywała napięcie z historii, która zapisuje jeden punkt na 15 minut, więc nowy odczyt (np. po włożeniu innego ogniwa) pojawiał się dopiero po kwadransie. Teraz „Bateria teraz”, procent i prognozy biorą zawsze najnowszy odczyt.

## 0.21.8

* „Ustaw stan licznika” przyjmuje teraz także **0** (wcześniej pole odrzucało zero).

## 0.21.7

* Test rozładowania zakończony wcześniej niż przy 3,0 V (szkic testowy liczył ze starym współczynnikiem 1,887 zamiast 2,044 i wyłączył się przy faktycznych około 3,25 V): apka przyjmuje taki przebieg, gdy test ma stan „finished”. Brakujący ogon krzywej (kilka procent) bierze z krzywej ogólnej i uwzględnia go w pojemności.
* Szkic `battery_test` ma teraz współczynnik 2,044, tak jak gazomierz.

## 0.21.6

* Odporność na restarty licznika: skoki odczytu, których gazomierz nie mógłby wykonać (powyżej około 8 m³ na godzinę), nie są liczone jako zużycie. Dotyczy panelu Energia, prognozy rachunku i modelu baterii. Przyczyna: stara, zatrzymana wartość retained na brokerze naprzemiennie z nowym licznikiem dawała w danych „zużycie” rzędu 400 m³.

## 0.21.5

* Wykres temperatury i zużycia: oś temperatury jest odwrócona (zimno u góry), więc linia temperatury biegnie zgodnie ze słupkami zużycia (im zimniej, tym więcej gazu). Strefa mrozu (poniżej 0 °C) ma jasnoniebieskie tło, linię zera i oznaczenie ❄.

## 0.21.4

* Progi baterii: zatrzymanie WiFi przy **3,00 V** (było 3,10 V), a hibernacja dopiero przy **2,85 V** (było 3,00 V). Dzięki temu między zatrzymaniem WiFi a hibernacją nadal zostaje zapas, w którym gazomierz liczy impulsy. Zmiana jest w firmware (`BATTERY_STOP_WIFI_V`, `BATTERY_CUTOFF_V`), więc wymaga wgrania szkicu; apka ma już nowe progi w prognozach.

## 0.21.3

* Prognoza w teście rozładowania: przy szybkim rozładowaniu (powyżej 25 % na dobę) trend jest liczony z ostatnich 4 godzin i startuje od prawdziwego naładowania. Wcześniej długi trend wychodził poniżej rzeczywistości, czas do 3,0 V wychodził 0 i linia prognozy w ogóle nie powstawała.

## 0.21.2

* Test rozładowania: wykres od razu pokazuje cały przebieg testu razem z prognozą (wcześniej okno 90 dni było tak szerokie, że prognoza na kilka godzin była niewidoczna).

## 0.21.1

* Zakładka Bateria: osobna karta „Test rozładowania baterii” (drugie to samo napięcie) zniknęła. Szczegóły testu (napięcie na pinie, czas, stan, WiFi, współczynnik dzielnika) są teraz w jednej karcie „Bateria teraz” po wybraniu widoku „Test rozładowania”.

## 0.21.0

* **Procent baterii zawsze na wierzchu:** zakładka Przegląd pokazuje teraz naładowanie z krzywej apki (nauczonej z Twojego testu) razem z szacowanym czasem pracy.
* **Prognoza baterii z sezonami:** model liczy dzień po dniu, ile sesji WiFi będzie w kolejnych miesiącach na podstawie zużycia gazu z faktur. Pokazuje czas do ostrzeżenia i do zatrzymania WiFi, tabelę zużycia baterii miesiąc po miesiącu i fioletową linię prognozy na wykresie.
* **Encje w Home Assistant** (MQTT discovery, urządzenie „Gas meter”), odświeżane co 10 minut: Bateria (szacunek, %), Czas pracy baterii (dni), Naładuj baterię do (data), Prognoza najbliższej faktury (PLN), Prognoza rachunków 12 miesięcy (PLN), Zużycie gazu w miesiącu (prognoza, m³). Nadają się do kafelków i automatyzacji.

## 0.20.0

* **Prognoza rachunku** (zakładka Zużycie): najbliższa faktura z zakresem (zużycie tego miesiąca z odczytów gazomierza do dziś, reszta z modelu pogody),
  suma na następne 12 miesięcy z porównaniem do roku wcześniej oraz tabela kolejnych miesięcy.
* Cena liczona jako opłata stała + cena za kWh, dopasowane do faktur z ostatnich 12 miesięcy.

## 0.19.0

* **Panel Energia:** apka wysyła do Home Assistanta własną statystykę „Gazomierz (z historią)” (`gas_meter_app:gas_history`, m³, z sumą).
  Do pierwszych odczytów gazomierza używa miesięcy z faktur rozłożonych równo na godziny, dalej godzinowych odczytów gazomierza
  (także tych zaimportowanych z Home Assistanta). Jedno źródło gazu w panelu Energia pokazuje więc całą historię.
* Nie zmienia żadnej istniejącej encji. Nowe godziny są dopisywane co godzinę, a statystykę można usunąć przyciskiem w apce.
  Wysyłka i usunięcie wymagają potwierdzenia.

## 0.18.1

* **Miesiące jako bloki:** co drugi miesiąc ma jasne tło, a w porównaniu lat i prognozie dochodzą pionowe podziałki między miesiącami.
* **Mała legenda przy każdym wykresie** (zużycie, historia encji, bateria, porównanie lat, pogoda, wykres punktowy, prognoza): kolor, rodzaj linii lub słupka i co oznacza.

## 0.18.0

* **Porównanie lat:** każdy rok z faktur ma przycisk, który włącza lub ukrywa jego słupki (do 8 lat naraz, każdy rok ma swój kolor), a nie tylko ostatnie 4 lata.
* **Wykres temperatury i zużycia w czasie** jest teraz w pełni interaktywny (przewijanie, kółko i dwa palce do przybliżania, przyciski, pasek przeglądu)
  i ma drugą oś (°C) po prawej. Wykres `TimeChart` obsługuje serie na prawej osi.
* Wykres punktowy (stopniodni a zużycie) i prognoza 12 miesięcy pokazują szczegóły po najechaniu lub dotknięciu.

## 0.17.1

* Karta „Pogoda a zużycie": nowy wykres **temperatury i zużycia w czasie** (słupki z faktur, niebieska linia średniej temperatury miesiąca,
  przerywana linia zużycia przewidywanego przez model). Wykres punktowy dostał opis, co oznaczają osie.

## 0.17.0

* **Pogoda a zużycie:** apka pobiera dobowe temperatury z darmowego archiwum Open-Meteo (bez konta i klucza; wysyła tylko współrzędne
  zaokrąglone do ok. 1 km, domyślnie z lokalizacji Home Assistanta, można je zmienić) i liczy stopniodni grzewcze (poniżej 15,5 °C).
* **Model zużycia:** zużycie miesięczne z faktur = stałe (woda, kuchnia) + współczynnik × stopniodni, z wykresem punktowym i R².
* **Prognoza na 12 miesięcy** przy typowej pogodzie z ostatnich lat oraz tabela **m³ na 1000 stopniodni** dla każdego sezonu grzewczego,
  czyli porównanie lat niezależne od tego, czy zima była zimna.

## 0.16.0

* **Ładniejszy wykres zużycia miesięcznego:** zaokrąglone słupki z gradientem i odstępami, podpisy miesięcy i lat na osi,
  szare tło sezonu grzewczego (październik–kwiecień), przerywana linia średniej z 12 miesięcy, podświetlany słupek pod palcem/myszą
  i tooltip z m³, kWh, kosztem w zł i ceną za kWh.
* **Nowa karta „Porównanie lat”:** ten sam miesiąc z ostatnich 4 lat obok siebie, z tooltipem po najechaniu.

## 0.15.0

* **Połączenie z integracją Orlen gas sensor** (HACS, `pawelhulek/pgnig-sensor`): apka sama znajduje jej encje po atrybutach,
  dopisuje **nowe faktury** (numer, termin, kwota, kWh i **m³**) i zapamiętuje odczyty z eBOK. Logowanie do eBOK (Orlen ID z kodem SMS)
  robi integracja, apka nie zna hasła. Sprawdzanie co 15 minut i przyciskiem „Pobierz teraz”.
* **Prawdziwy współczynnik kWh/m³** z faktur (mediana z faktur, które podają m³) zamiast domyślnych 11,0. Ręczny zapis współczynnika nadal ma pierwszeństwo.
  Zużycie miesięczne w m³ jest brane wprost z faktur, gdy faktura je podaje, a w pozostałych miesiącach przeliczane.
* **Porównanie z Orlenem:** odczyt zapisany w eBOK jest zestawiany ze stanem naszego gazomierza z tego samego dnia (różnica w m³).
* Faktura dopisana przez integrację nie dubluje tej, którą wcześniej wklejono z tabeli (dopasowanie po numerze albo po terminie i kWh).

## 0.14.0

* Nowa zakładka **Zużycie** ze statystykami z faktur: kafelki (ostatnie 12 miesięcy w m³ i kWh, koszt, średnia cena, rok do roku),
  interaktywny wykres miesięczny (m³, kWh albo zł, z przewijaniem i zoomem), **profil sezonowy** (średnie zużycie na miesiąc i
  impulsy na dobę, czyli to, co gazomierz będzie liczył w danym miesiącu) oraz tabela roczna.
* **Import faktur z eBOK:** wklejasz tabelę ze strony „Faktury” (zaznacz, skopiuj, wklej), apka ją rozbiera (numer, termin, kwota,
  zużycie w kWh, noty odsetkowe są pomijane), pokazuje podgląd i po potwierdzeniu zapisuje. Ponowne wklejenie aktualizuje
  istniejące faktury i dodaje nowe. Dane zostają tylko w apce. Apka nie loguje się do eBOK i nie zna hasła.
* **Kalibracja współczynnika kWh/m³:** apka porównuje faktury z historią stanu licznika z tych samych miesięcy (np. po imporcie z Home Assistant)
  i podpowiada współczynnik (mediana z miesięcy). Przycisk „Użyj” go zapisuje.

## 0.13.0

* **Import historii z Home Assistant.** Zakładka Serwis, karta „Historia z Home Assistant”: apka czyta statystyki długoterminowe
  wybranej encji (np. `sensor.gazomierz`) przez API Home Assistant i dołącza je do swojej historii. Nie trzeba eksportować CSV.
  Wybierasz encję z listy (rodzaj, czyli stan licznika w m³ albo napięcie baterii w V, ustawia się sam według jednostki), oglądasz
  podgląd (zakres dat, liczba punktów, pierwsza i ostatnia wartość) i po potwierdzeniu importujesz. Jeśli encja liczy w impulsach,
  wpisz dzielnik (impulsów na m³). Zaimportowane dane są tylko starsze niż pierwszy odczyt z nowego gazomierza, nie zmieniają niczego
  w Home Assistant i można je usunąć jednym przyciskiem.
* Wykresy, zużycie na godzinę, przepływ i statystyki korzystają ze scalonej historii. Okno historii sięga do 10 lat wstecz,
  historia stanu licznika jest przechowywana dłużej (do 150 000 punktów), a daty w długich zakresach mają rok.

## 0.12.1

* Delikatny efekt przejścia między zakładkami (gest w bok albo kliknięcie zakładki): stara zakładka lekko odsuwa się i blednie,
  nowa płynnie wjeżdża z kierunku gestu, a podkreślenie aktywnej zakładki w nagłówku płynnie przesuwa się pod nową.
  Efekt wyłącza się przy ustawieniu systemu „ogranicz animacje”.
* Gest w bok nie jest już ignorowany na polach tekstowych (tylko na polu, które właśnie edytujesz, na suwakach i listach wyboru),
  bo na stronie Ustawienia wyglądało to jak „gest czasem nie działa”.

## 0.12.0

* **Potwierdzenia wrażliwych akcji.** Przed wysłaniem do gazomierza apka pyta o potwierdzenie przy: restarcie gazomierza,
  aktualizacji firmware, włączeniu i wyłączeniu trybu serwisowego, zmianie stałego IP i wszystkich ustawień sieci (IP, brama,
  maska, DNS, nazwa i hasło WiFi), ustawianiu stanu licznika oraz zmianie parametrów (odstęp wysyłki, odstęp raportu,
  debounce, impulsy na m³, kalibracja i progi baterii). Okno pokazuje, co się zmieni (np. „100 ms → 150 ms”,
  stary i nowy stan licznika w m³), ostrzega o skutkach i można je zamknąć przyciskiem Anuluj, klawiszem Esc albo kliknięciem w tło.
  Przy akcjach niebezpiecznych przycisk potwierdzenia jest przez chwilę zablokowany, żeby nie zadziałał od przypadkowego
  podwójnego dotknięcia. Hasło WiFi jest w oknie ukryte.
* Do tej pory przycisk restartu używał systemowego okna potwierdzenia, które w ramce Home Assistant bywa po cichu blokowane,
  więc mógł nie robić nic. Teraz jest własne okno.
* „Ustaw stan licznika” nie przyjmuje pustego pola (wcześniej puste pole oznaczało 0 impulsów).
* **Demo i suwaki:** przewijanie w pionie czasem „nie łapało”, gdy palec zaczynał się na suwaku (suwak przechwytywał dotyk).
  Suwaki i wykresy pozwalają teraz przewijać stronę, a ramka Demo nie ma własnego przewijania. Przesunięcie w bok w Demo
  przełącza zakładkę.

## 0.11.0

* **Przełączanie zakładek gestem:** przesunięcie palcem w lewo albo w prawo na stronie przechodzi do następnej lub poprzedniej
  zakładki (z krótką animacją). Gest nie działa na polach tekstowych, suwakach, pasku zakładek, w oknie historii ani na pasku
  przeglądu wykresu, więc nie koliduje z ich obsługą.
* **Przewijanie strony:** wykresy i pasek zakładek przechwytywały ruchy palca w poziomie, przez co przewijanie w pionie
  czasem „nie łapało”, zależnie od miejsca dotknięcia. Teraz **jeden palec na wykresie przewija stronę**, a wykres
  powiększasz i przesuwasz **dwoma palcami**. Dotknięcie pokazuje wartość, a pasek przeglądu pod wykresem przesuwa okno jednym palcem.
  Na komputerze nic się nie zmienia (przeciąganie, kółko myszy, dwuklik).
* Węższe przyciski zakładek na telefonie, żeby więcej się mieściło bez przewijania paska.

## 0.10.0

* **Naprawa:** od wersji 0.9.0 kafelki w Przeglądzie nie otwierały historii po kliknięciu (przy przebudowie na kafelki
  usunąłem obsługę kliknięcia). Teraz znów działają, a kafel Bateria pokazuje napięcie baterii.
* Nowy interaktywny wykres w oknie historii i w zakładce Bateria: przewijanie przeciąganiem, zoom kółkiem myszy, szczypaniem
  (telefon) i przyciskami +/−, dwuklik pokazuje cały zakres, pasek przeglądu całej historii z przesuwanym oknem,
  podpowiedź z dokładną wartością i czasem, przyciski zakresów (od 1 godz. do wszystkiego), gradient pod linią,
  słupki dla zużycia, linie progów i znacznik „teraz”. Po powiększeniu wykres dociąga dokładniejsze dane z wybranego okna.
* Gdy gazomierz nie przysłał jeszcze danych baterii, okno historii to wyjaśnia i podpowiada zakładkę Bateria (jest tam test rozładowania).
* Historia ma teraz więcej punktów (do 5000) i okno historii sięga do 400 dni wstecz.

## 0.9.3

* Nazwa apki w sklepie i w pasku bocznym: **Energia Gazomierz** (żeby była obok „Energia Woda” w kolejności alfabetycznej).

## 0.9.2

* Naprawa: po aktualizacji panel mógł zostać na „Ładowanie…”, bo przeglądarka (albo aplikacja HA) trzymała starą kopię
  skryptu. Adresy plików mają teraz numer wersji, a pliki statyczne wysyłane są bez buforowania.
  Jeśli panel nadal się nie ładuje po aktualizacji, odśwież stronę (w aplikacji HA: zamknij i otwórz panel ponownie).

## 0.9.1

* Logo ORLEN w nagłówku i na ikonie apki (pliki dostarczone przez użytkownika), czerwień motywu dopasowana do logo (#D81E05).

## 0.9.0

* Nowy wygląd w stylu ORLEN i układzie aplikacji GPK Szemud: czerwony nagłówek z logo, zakładki w nagłówku,
  kafelki z odczytami w Przeglądzie, stan połączenia i przycisk odświeżania.
* Nazwa apki zmieniona na **Gazomierz**. Interfejs, powiadomienia, opisy opcji i dokumentacja tylko po polsku.
* Własne logo i ikona (płomień i tarcza licznika). Oficjalnego logo ORLEN nie dołączam, żeby podmienić je na własne,
  zastąp pliki `static/logo.png` i `icon.png`.
* Opcja `language` jest ignorowana.

## 0.8.0

* Choose who gets the battery notifications in the panel (Battery tab): the people of your Home Assistant
  with their phones, plus other phones with the Companion app. Several people or phones can be ticked.
  The option `notify_service` is now only an optional extra target.

## 0.7.1

* Notifications: the test button and the list of recent messages now say why a message was not delivered
  (wrong `notify_service` name, no permission for the Home Assistant API, ...) instead of always showing "sent".

## 0.7.0

* Battery notifications through Home Assistant: periodic report (charge and estimated life, charge-by date),
  warnings when the battery has to be charged (with reminders), a note when it was charged and an alert when
  the meter is silent. A notification in Home Assistant and optionally a push to the phone (`notify_service`).
* New options: `notify_service`, `notify_persistent`, `battery_report`, `battery_warn_days`,
  `battery_critical_days`, `silent_alert_hours`.
* Battery tab: notification status, test and "send the report now" buttons, list of recent messages.
* The forecast now always runs to the thresholds the firmware really uses (3.10 V, 3.00 V).

## 0.6.0

* The panel is split into tabs: **Overview**, **Battery**, **Settings**, **Network**, **Service**, **Demo**.
  The discharge test card moved to the Battery tab, diagnostics to Service.
* A number on a tab shows how many commands wait for the meter. The last used tab is remembered.
* Short explanation at the top of Settings, Network and Service.

## 0.5.0

* Battery settings: cell type (NCR18650GA, NCR18650B, NCR18650PF, 35E, 30Q, MJ1, 25R or custom),
  number of cells and usable part of the label capacity. The Battery tab shows how the capacity was
  calculated. This replaces the `battery_capacity_mah` option of 0.4.0.
* Real capacity of your cell from the discharge test: enter the test current and the number of cells,
  the panel computes the capacity (while the test runs as an estimate, afterwards as a measurement),
  saves it and uses it for the life prediction.

## 0.4.0

* New **Battery** tab: voltage history with a forecast to the WiFi stop voltage and the cut-off
  voltage, two independent life predictions (usage model and voltage trend, with a confidence level),
  where the energy goes (sleep, self-discharge, WiFi sessions), a "what if" slider (battery life for a
  different gas use) and nerd statistics (pulses, sessions and wake-ups per day, average current,
  mAh per m³ of gas, WiFi connect time and signal).
* The panel learns the real discharge curve of your cells from the discharge test
  (`firmware/battery_test`) when a run reaches 3.0 V and uses it instead of the generic curve.
* Battery, signal and session history is kept for about a year (one sample per 15 minutes).
* New option `battery_capacity_mah` (default 5900, two 18650 cells with a reserve for cold).
* Fix: the active tab highlight of the history window and chart tabs no longer disappears.

## 0.3.0

* History of every value: click the meter reading, flow, today, battery, WiFi signal (or the battery
  test values) to open a "more info" style window with a chart, range buttons (1 h to 14 days),
  hover readout and min / max / average.
* New **Demo** tab with the visual simulator (spinning gas meter, reed, ESP32 sleep / WiFi timeline,
  Home Assistant view, battery estimate). It is also available without Home Assistant in
  `docs/simulator/` of the repository.

## 0.2.0

* Battery discharge test card and chart: the panel also listens to the topic of the
  `firmware/battery_test` sketch (option `battery_test_topic`, default `Gaz/BatteryTest`).
  The voltage is recalculated from the pin voltage with an adjustable divider factor.

## 0.1.1

* Show a notice while the meter has not published any data yet.

## 0.1.0

* First version: sidebar panel with readings (meter, flow, today, battery, WiFi), hourly
  consumption and battery charts, settings, service mode, network settings, set meter reading,
  diagnostics. MQTT discovery for the meter reading, battery voltage, battery percent and signal.
