VoyteckPL/gas-meter-arduino/home-assistant/packages/gas_meter.yaml

# Home Assistant package for the battery powered gas meter.
#
# Install: copy this file to /config/packages/gas_meter.yaml and make sure
# configuration.yaml contains
#
#   homeassistant:
#     packages: !include_dir_named packages
#
# Then restart Home Assistant (or reload the MQTT integration).
#
# Everything is MQTT. The meter sleeps most of the time, so all commands are
# RETAINED: the broker keeps them until the meter wakes up, reads them and
# clears them (see docs/mqtt-topics.md).
#
# Entities that the firmware does not publish yet (stage 2) simply show
# "unknown" until the firmware supports them.

mqtt:
  sensor:
    # ---------------------------------------------------------------- readings
    - name: "Cubic meters"
      unique_id: gas_meter_cubic_meters
      state_topic: "Gaz/Gazomierz/cubic_meters"
      unit_of_measurement: "m³"
      device_class: gas
      state_class: total_increasing
      suggested_display_precision: 2
      device: &gas_device
        identifiers: ["gas_meter_fb2"]
        name: "Gas meter"
        manufacturer: "DFRobot"
        model: "FireBeetle 2 ESP32-UE (DFR1140)"

    - name: "Flow"
      unique_id: gas_meter_flow
      state_topic: "Gaz/Gazomierz/flow_m3h"
      unit_of_measurement: "m³/h"
      state_class: measurement
      suggested_display_precision: 2
      device: *gas_device

    - name: "Battery voltage"
      unique_id: gas_meter_battery_voltage
      state_topic: "Gaz/Gazomierz/BatteryVoltage"
      unit_of_measurement: "V"
      device_class: voltage
      state_class: measurement
      suggested_display_precision: 2
      device: *gas_device

    - name: "Battery"
      unique_id: gas_meter_battery
      state_topic: "Gaz/Gazomierz/BatteryPercent"
      unit_of_measurement: "%"
      device_class: battery
      state_class: measurement
      device: *gas_device

    - name: "WiFi signal"
      unique_id: gas_meter_wifi_signal
      state_topic: "Gaz/Gazomierz/RSSI"
      unit_of_measurement: "dBm"
      device_class: signal_strength
      state_class: measurement
      entity_category: diagnostic
      device: *gas_device

    # -------------------------------------------------------------- diagnostics
    - name: "Pulse counter"
      unique_id: gas_meter_pulse_counter
      state_topic: "Gaz/Gazomierz/counter"
      state_class: total_increasing
      entity_category: diagnostic
      device: *gas_device

    - name: "Pending pulses"
      unique_id: gas_meter_pending_pulses
      state_topic: "Gaz/Gazomierz/pending"
      entity_category: diagnostic
      device: *gas_device

    - name: "Wake-ups"
      unique_id: gas_meter_wake_ups
      state_topic: "Gaz/Gazomierz/Wakes"
      state_class: total_increasing
      entity_category: diagnostic
      device: *gas_device

    - name: "WiFi sessions"
      unique_id: gas_meter_wifi_sessions
      state_topic: "Gaz/Gazomierz/WifiSessions"
      state_class: total_increasing
      entity_category: diagnostic
      device: *gas_device

    - name: "Wake-ups per pulse"
      unique_id: gas_meter_wake_ups_per_pulse
      state_topic: "Gaz/Gazomierz/wakes_per_pulse"
      state_class: measurement
      suggested_display_precision: 2
      entity_category: diagnostic
      device: *gas_device

    - name: "WiFi connect time"
      unique_id: gas_meter_wifi_connect_time
      state_topic: "Gaz/Gazomierz/wifi_connect_ms"
      unit_of_measurement: "ms"
      state_class: measurement
      entity_category: diagnostic
      device: *gas_device

    - name: "Uptime"
      unique_id: gas_meter_uptime
      state_topic: "Gaz/Gazomierz/uptime_s"
      unit_of_measurement: "s"
      device_class: duration
      state_class: measurement
      entity_category: diagnostic
      device: *gas_device

    - name: "Reset reason"
      unique_id: gas_meter_reset_reason
      state_topic: "Gaz/Gazomierz/reset_reason"
      entity_category: diagnostic
      device: *gas_device

    - name: "Firmware version"
      unique_id: gas_meter_firmware_version
      state_topic: "Gaz/Gazomierz/fw_version"
      entity_category: diagnostic
      device: *gas_device

    - name: "Service state"
      unique_id: gas_meter_service_state
      state_topic: "Gaz/Gazomierz/service_state"
      entity_category: diagnostic
      device: *gas_device

    # ------------------------------------------------------------------ network
    - name: "IP address"
      unique_id: gas_meter_ip_address
      state_topic: "Gaz/Gazomierz/ip"
      entity_category: diagnostic
      device: *gas_device

    - name: "MAC address"
      unique_id: gas_meter_mac_address
      state_topic: "Gaz/Gazomierz/mac"
      entity_category: diagnostic
      device: *gas_device

    - name: "WiFi network"
      unique_id: gas_meter_wifi_network
      state_topic: "Gaz/Gazomierz/ssid"
      entity_category: diagnostic
      device: *gas_device

    - name: "Access point"
      unique_id: gas_meter_access_point
      state_topic: "Gaz/Gazomierz/bssid"
      entity_category: diagnostic
      device: *gas_device

  # -------------------------------------------------------------------- settings
  number:
    - name: "Send interval"
      unique_id: gas_meter_send_interval
      command_topic: "Gaz/Gazomierz/set/send_interval"
      state_topic: "Gaz/Gazomierz/cfg/send_interval"
      retain: true
      optimistic: true
      mode: box
      min: 0
      max: 3600
      step: 1
      unit_of_measurement: "s"
      entity_category: config
      device: *gas_device

    - name: "Status interval"
      unique_id: gas_meter_status_interval
      command_topic: "Gaz/Gazomierz/set/status_interval"
      state_topic: "Gaz/Gazomierz/cfg/status_interval"
      retain: true
      optimistic: true
      mode: box
      min: 1
      max: 48
      step: 1
      unit_of_measurement: "h"
      entity_category: config
      device: *gas_device

    - name: "Debounce"
      unique_id: gas_meter_debounce
      command_topic: "Gaz/Gazomierz/set/debounce"
      state_topic: "Gaz/Gazomierz/cfg/debounce"
      retain: true
      optimistic: true
      mode: box
      min: 10
      max: 2000
      step: 10
      unit_of_measurement: "ms"
      entity_category: config
      device: *gas_device

    - name: "Pulses per cubic meter"
      unique_id: gas_meter_pulses_per_cubic_meter
      command_topic: "Gaz/Gazomierz/set/pulses_per_m3"
      state_topic: "Gaz/Gazomierz/cfg/pulses_per_m3"
      retain: true
      optimistic: true
      mode: box
      min: 1
      max: 10000
      step: 1
      entity_category: config
      device: *gas_device

    - name: "Battery calibration"
      unique_id: gas_meter_battery_calibration
      command_topic: "Gaz/Gazomierz/set/battery_cal"
      state_topic: "Gaz/Gazomierz/cfg/battery_cal"
      retain: true
      optimistic: true
      mode: box
      min: 1.5
      max: 2.5
      step: 0.001
      entity_category: config
      device: *gas_device

    - name: "Battery warning voltage"
      unique_id: gas_meter_battery_warning_voltage
      command_topic: "Gaz/Gazomierz/set/battery_warn_v"
      state_topic: "Gaz/Gazomierz/cfg/battery_warn_v"
      retain: true
      optimistic: true
      mode: box
      min: 3.2
      max: 4.0
      step: 0.05
      unit_of_measurement: "V"
      entity_category: config
      device: *gas_device

    - name: "Battery cutoff voltage"
      unique_id: gas_meter_battery_cutoff_voltage
      command_topic: "Gaz/Gazomierz/set/battery_cutoff_v"
      state_topic: "Gaz/Gazomierz/cfg/battery_cutoff_v"
      retain: true
      optimistic: true
      mode: box
      min: 2.8
      max: 3.4
      step: 0.05
      unit_of_measurement: "V"
      entity_category: config
      device: *gas_device

    # Meter reading in pulses (reading in m3 x pulses per m3, e.g. 7282.35 m3 -> 728235).
    # The firmware reads it after a power-on / restart (stage 1) and clears it, so it is applied once.
    - name: "Set counter"
      unique_id: gas_meter_set_counter
      command_topic: "Gaz/Gazomierz/config/counter"
      retain: true
      optimistic: true
      mode: box
      min: 0
      max: 99999999
      step: 1
      entity_category: config
      device: *gas_device

  switch:
    - name: "Service mode"
      icon: mdi:wrench
      unique_id: gas_meter_service_mode
      command_topic: "Gaz/Gazomierz/set/service_mode"
      state_topic: "Gaz/Gazomierz/cfg/service_mode"
      payload_on: "ON"
      payload_off: "OFF"
      state_on: "ON"
      state_off: "OFF"
      retain: true
      optimistic: true
      device: *gas_device

    - name: "Static IP"
      unique_id: gas_meter_static_ip
      command_topic: "Gaz/Gazomierz/set/static_ip"
      state_topic: "Gaz/Gazomierz/cfg/static_ip"
      payload_on: "ON"
      payload_off: "OFF"
      state_on: "ON"
      state_off: "OFF"
      retain: true
      optimistic: true
      entity_category: config
      device: *gas_device

  text:
    - name: "Static IP address"
      unique_id: gas_meter_static_ip_address
      command_topic: "Gaz/Gazomierz/set/ip"
      state_topic: "Gaz/Gazomierz/cfg/ip"
      retain: true
      min: 7
      max: 15
      pattern: '^\d{1,3}\.\d{1,3}\.\d{1,3}\.\d{1,3}$'
      entity_category: config
      device: *gas_device

    - name: "Gateway"
      unique_id: gas_meter_gateway
      command_topic: "Gaz/Gazomierz/set/gateway"
      state_topic: "Gaz/Gazomierz/cfg/gateway"
      retain: true
      min: 7
      max: 15
      pattern: '^\d{1,3}\.\d{1,3}\.\d{1,3}\.\d{1,3}$'
      entity_category: config
      device: *gas_device

    - name: "Subnet mask"
      unique_id: gas_meter_subnet_mask
      command_topic: "Gaz/Gazomierz/set/subnet"
      state_topic: "Gaz/Gazomierz/cfg/subnet"
      retain: true
      min: 7
      max: 15
      pattern: '^\d{1,3}\.\d{1,3}\.\d{1,3}\.\d{1,3}$'
      entity_category: config
      device: *gas_device

    - name: "DNS server"
      unique_id: gas_meter_dns_server
      command_topic: "Gaz/Gazomierz/set/dns"
      state_topic: "Gaz/Gazomierz/cfg/dns"
      retain: true
      min: 7
      max: 15
      pattern: '^\d{1,3}\.\d{1,3}\.\d{1,3}\.\d{1,3}$'
      entity_category: config
      device: *gas_device

    - name: "WiFi SSID"
      unique_id: gas_meter_wifi_ssid
      command_topic: "Gaz/Gazomierz/set/wifi_ssid"
      state_topic: "Gaz/Gazomierz/cfg/wifi_ssid"
      retain: true
      min: 1
      max: 32
      entity_category: config
      device: *gas_device

    # Write-only: the meter never publishes the password back.
    - name: "WiFi password"
      unique_id: gas_meter_wifi_password
      command_topic: "Gaz/Gazomierz/set/wifi_password"
      retain: true
      mode: password
      min: 8
      max: 63
      entity_category: config
      device: *gas_device

  button:
    - name: "Restart"
      unique_id: gas_meter_restart
      command_topic: "Gaz/Gazomierz/set/restart"
      payload_press: "RESTART"
      retain: true
      device_class: restart
      device: *gas_device

  # Firmware update. The meter publishes the JSON
  #   {"installed_version": "1.0.0", "latest_version": "1.0.1"}
  # to <root>/update and installs the firmware from the URL in <root>/update_url
  # when it receives INSTALL while in service mode.
  update:
    - name: "Firmware"
      unique_id: gas_meter_firmware
      state_topic: "Gaz/Gazomierz/update"
      command_topic: "Gaz/Gazomierz/set/update"
      payload_install: "INSTALL"
      retain: true
      device_class: firmware
      device: *gas_device

# Daily / monthly consumption. If the source entity id differs on your system
# (check Settings -> Devices -> Gas meter), adjust it here.
utility_meter:
  gas_meter_daily:
    name: "Gas daily"
    source: sensor.gas_meter_cubic_meters
    cycle: daily
  gas_meter_monthly:
    name: "Gas monthly"
    source: sensor.gas_meter_cubic_meters
    cycle: monthly
