VoyteckPL/gas-meter-arduino/firmware/gas_meter/secrets.example.h

// Copy this file to "secrets.h" in the same folder and fill in your own values.
// "secrets.h" is listed in .gitignore and must never be committed.
#pragma once

#define WIFI_SSID        "YOUR_WIFI_SSID"
#define WIFI_PASSWORD    "YOUR_WIFI_PASSWORD"

// Optional, saves battery: the WPA key as 64 hex characters, so the meter does not derive it from the password at
// every connection. Compute it once on Windows (PowerShell), with your own name and password:
//   $k = New-Object System.Security.Cryptography.Rfc2898DeriveBytes('YOUR_WIFI_PASSWORD', [Text.Encoding]::UTF8.GetBytes('YOUR_WIFI_SSID'), 4096)
//   ($k.GetBytes(32) | % { $_.ToString('x2') }) -join ''
// or on Linux/macOS: wpa_passphrase "YOUR_WIFI_SSID" "YOUR_WIFI_PASSWORD"   (the line psk=...)
// Never paste the password into a website for this.
// #define WIFI_PSK_HEX "0123456789abcdef0123456789abcdef0123456789abcdef0123456789abcdef"

#define MQTT_SERVER_IP   192, 168, 1, 9
#define MQTT_USERNAME    "YOUR_MQTT_USER"
#define MQTT_PASSWORD    "YOUR_MQTT_PASSWORD"

// Optional: MAC address (BSSID) of the access point the meter should prefer, for example the
// outdoor Deco next to the gas meter. The meter tries it first and uses another access point
// with the same WiFi name only if it is not reachable. The BSSID of the access point the meter is
// connected to is shown in the panel ("Access point"). Use the 2.4 GHz address.
// #define WIFI_PREFERRED_BSSID "AA:BB:CC:DD:EE:FF"

// Optional: key of the update over the air (firmware 0.3.0 and newer). Any long random text (at least 12 characters), the
// same text as the "ota_key" option of the Gas Meter app. The app signs every update with it and the meter installs nothing
// that is not signed. Without this line the meter cannot be updated over the air (only with the cable).
// #define OTA_KEY "put-a-long-random-text-here"
