VoyteckPL/gas-meter-arduino/(commit log)

2026-10-27 Initial import: gas meter firmware, battery test and Home Assistant package
    - firmware/gas_meter: deep sleep pulse counter for a bellows gas meter with
    batched WiFi/MQTT sessions, battery measurement on GPIO36 and counter restore
    - firmware/battery_test: discharge logger for calibrating the battery divider
    - home-assistant: MQTT package (sensors, settings, service mode, update) and dashboard
    - docs: MQTT topic contract, wiring and reed pull-up diagrams, panel mockup
    - credentials are kept in secrets.h (git-ignored), only secrets.example.h is committed
    Claude-Session: https://claude.ai/code/session_013oEd7WB4wFq5mMQkJAbXKe
2026-10-27 Add the Gas Meter Home Assistant app (add-on) with a sidebar panel
    - gas_meter_app: aiohttp + paho-mqtt backend with an ingress web UI (readings,
    flow and consumption charts, battery, settings, service mode, network settings,
    set meter reading, diagnostics), Polish and English
    - settings are written as retained MQTT commands and shown as "waiting for the meter"
    until the sleeping meter has applied them
    - MQTT discovery for the meter reading (m3), battery voltage, battery percent and signal
    - repository.yaml so the repository can be added in the add-on store
    - README updated: install the app, YAML package is the alternative
    Clau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
2026-10-27 Show the battery discharge test in the panel (app 0.2.0)
    The panel also listens to the topic of the battery_test sketch and shows the
    voltage, pin voltage, running time and a discharge chart. The voltage is
    recalculated from the pin voltage with an adjustable divider factor.
    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
2026-10-27 Add the status to WiFi sessions that happen anyway
    When a WiFi session is started by a pulse and the last status is older than
    STATUS_PIGGYBACK_S (5 min), the status (battery, RSSI, diagnostics) is added
    to it. This keeps the status fresh during heating at almost no battery cost,
    while the standalone status session stays at STATUS_INTERVAL_S (6 h).
    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
2026-10-27 Firmware: loss-free pulse counting, flash backup, flutter protection, preferred AP, LED
    - count pulses by interrupt while awake (contact chatter on closing and opening ignored)
    - count pulses that are already over when the chip has started (short_pulses)
    - never leave the awake state without a final check that the reed did not move
    - back up the counter in flash after every change; never publish a relative counter
    - flutter protection (too many wake-ups -> sleep 30 s), bounded debounce wait
    - status: firmware version, reset reason, uptime, pending, wake-ups per pulse, WiFi connect time,
    short pulses, chatter events, restarts, IP/MAC/SSID/BSSID
    - optional WIFI_PREFERRED_BSSID (outdoor acces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
    [gas_meter.ino, secrets.example.h, sim.h, test_gas_meter.cpp]
2026-10-27 App 0.4.0: Battery tab with life prediction, forecast chart and nerd statistics
    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
2026-10-27 App 0.5.0: battery type and cell count, capacity measured from the discharge test
    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
2026-10-27 App 0.6.0: tabs (Overview, Battery, Settings, Network, Service, Demo), pending badges
    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
2026-10-27 App 0.7.0: battery notifications (report, warnings, charged, silent meter)
    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
2026-10-28 Add checklist before mounting; BATTERY_DIVIDER 2.044 as measured
    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
2026-10-28 App 0.9.2: version the static file URLs and send them without caching (fixes a page stuck on loading after an update)
    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
    [config.yaml]
2026-10-28 App 0.10.0: interactive zoomable chart, fix tiles not opening history
    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
    [config.yaml]
2026-10-28 App 0.11.0: swipe between tabs, one finger on charts scrolls the page
    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
2026-10-28 App 0.12.0: confirmation dialogs for sensitive actions, sliders no longer trap vertical scroll in Demo
    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
    [config.yaml]
2026-10-28 Docs: how to measure the discharge test current (diagram and steps)
    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
2026-10-28 App 0.13.0: import long-term statistics from Home Assistant (meter and battery history)
    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
2026-10-28 App 0.14.0: Usage tab with statistics from invoices (pasted from the customer portal), seasonal profile, kWh per m3 calibration
    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
2026-10-28 App 0.15.0: link to the Orlen gas sensor integration (new invoices, real kWh per m3, reading comparison)
    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
2026-10-28 App 0.17.0: outdoor temperature, degree days, usage model and 12 month forecast
    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
2026-10-28 App 0.17.1: temperature and usage over time chart, clearer scatter explanation
    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
2026-10-28 App 0.18.0: selectable years in year comparison, zoomable temperature chart with right axis, hover on scatter and forecast
    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
2026-10-28 Docs: wiring diagram with Wago connectors, no power switch
    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
2026-10-28 Docs: Wago wiring for a two cell holder with the bridge inside
    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
2026-10-28 App 0.21.0: seasonal battery forecast, battery percent on the overview and HA entities for the app's own estimates
    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
2026-10-28 App 0.21.1: merge the discharge test card into the Battery now card
    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
2026-10-28 WiFi stop at 3.00 V and hibernate at 2.85 V (firmware and app forecasts)
    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
2026-10-28 Back to WiFi stop 3.10 V and hibernate 3.00 V
    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
2026-10-28 App 0.21.5: inverted temperature axis with a frost zone
    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
    [config.yaml]
2026-10-28 App 0.21.7: accept a discharge test that finished early; battery_test divider 2.044
    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
2026-10-28 Firmware 0.2.3: quick first retries after a failed session, log the failure
    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
    [gas_meter.ino]
2026-10-28 Firmware 0.2.5: a new pulse is sent at once even after a failed session, acknowledged (QoS 1) counter publish
    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
    [gas_meter.ino]
2026-10-28 Firmware 0.2.6: debounce 300 ms (a hand touch on bare wires bounced into two pulses)
    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
2026-10-28 Firmware 0.2.7: a pulse is a closure of at least 150 ms; brushes and chatter never count
    The old logic counted a pulse at the first closing edge after 300 ms of quiet and also
    counted wake-ups by closures that were already over. Wires brushing each other when
    they were let go then made two pulses out of one. Now the closure must last
    MIN_CLOSED_MS and the next one needs DEBOUNCE_MS of open contact first. Simulator
    tests for brushes after each pulse added.
    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
2026-10-28 Firmware: fix a comment
    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
    [gas_meter.ino]
2026-10-28 Firmware 0.2.9: no WiFi modem sleep during the session (broker answers wait for beacons), timing log
    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
    [gas_meter.ino, sim.h]
2026-10-28 Firmware 0.2.10: back to 80 MHz (key derivation no longer needed with the hex key)
    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
    [gas_meter.ino]
2026-10-28 Firmware 0.2.11: one acknowledged message per session, shorter command check
    All messages of a session go out with QoS 0 and the counter last with QoS 1: its
    acknowledgement confirms the whole session (in-order delivery on one connection).
    A missing acknowledgement now fails the session, so it is repeated. The command
    check waits 100 ms and no longer unsubscribes. Simulator tests for missing
    acknowledgements added.
    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
    [gas_meter.ino, sim.h, test_gas_meter.cpp]
2026-10-28 App 0.21.9: the battery view uses the newest voltage, not only the 15-minute history
    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
2026-10-28 Firmware 0.2.12: divider factor 1.978 measured at light load on the soldered build
    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
2026-10-28 App 0.21.10: battery forecast from the first day (pulses from the invoices), measured session cost
    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
2026-10-28 App 0.21.11: the Battery tab refreshes at once when a new voltage arrives
    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
2026-10-28 App 0.21.12: the battery model counts the wake-up at the opening of the contact
    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
2026-10-28 App 0.21.13: month and year labels on the battery chart for long ranges
    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
2026-10-28 App 0.22.0: split gas use into hot water and heating from the boiler state
    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
2026-10-28 App 0.23.0: monthly boiler split and hot water / heating / rest statistics for the Energy panel
    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
2026-10-29 App 0.24.0: merge several statistics into one gas history, find and correct jumps
    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
    [config.yaml]
2026-10-29 App 0.24.1: charts keep their swipe, a correction no longer drops the preview
    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
    [config.yaml]
2026-10-29 App 0.25.0: fill empty days with the usual consumption, bulk corrections
    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
    [config.yaml]
2026-10-29 App 0.26.0: real entity with the merged history, click a bar to correct a day, touch panning
    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
    [config.yaml]
2026-10-29 Firmware: abort a failed update cleanly
    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
    [gas_meter.ino, sim.h]
2026-10-29 Firmware 0.3.3 reports that an OTA request was accepted and why a download failed; app 0.29.2
    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
    [config.yaml, gas_meter.ino, sim.h, test_gas_meter.cpp]
2026-10-29 App 0.30.1: show whether the update request is on the broker, republish it if it vanished
    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
    [config.yaml]
2026-10-29 App 0.30.5: History tab, obsolete retained commands removed from the broker, counter hint updated
    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
    [config.yaml]
2026-10-29 Firmware 0.4.2: a broker outage no longer switches the meter to DHCP for good, pulses retry at least once a minute
    DHCP is tried every other attempt from the third failure; after a DHCP success the static address is checked once
    more and DHCP is kept for 50 sessions only when it fails. During a longer outage a pulse starts a session at most once
    a minute instead of waiting for the 4 and 15 minute retries.
    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
    [gas_meter.ino, sim.h, test_gas_meter.cpp]
2026-10-29 Firmware 0.4.3: production build of 0.4.2 (no log, no LED), the version installed in the meter
    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
2026-10-29 Firmware 0.4.4 and app 0.30.8: the meter reports its time awake, the battery model uses it
    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
2026-10-29 App 0.30.10: the overview skips the jump of a counter that was set (today, flow, hourly chart)
    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
    [config.yaml]
2026-10-29 App 0.30.12: gas charts coloured by what the boiler was doing (hot water, heating)
    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
2026-10-29 App 0.30.14: the fresh start fixes the counter jumps of both gas sensors in the HA statistics
    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
    [config.yaml]
2026-10-29 App 0.30.17: load a prepared history into the gas sensor statistics, the device and the main sensor are called Gazomierz
    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
2026-10-29 App 0.30.18: loading a prepared history runs in the background over one connection (long histories were cut off by the request timeout)
    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
2026-10-29 App 0.31.0: the history merging and the one-off cleanup tools are removed, the history lives in the statistics of the gas sensor
    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
2026-10-30 App 0.34.0: gas flow entity, tabs tidied (OTA tab with the counter, no Settings and Demo), opens on the overview, battery screen tidied
    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
2026-10-30 App 0.45.0: temperatura na zewnątrz na Przeglądzie
    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
2026-11-02 Add mean_type and unit_class to recorder/import_statistics metadata
    HA Core 2026.11 stops accepting recorder/import_statistics calls that omit
    mean_type and unit_class. Replace has_mean with mean_type: 0 and always send
    unit_class (None when there is no compatible unit converter, e.g. PLN).
    Claude-Session: https://claude.ai/code/session_013oEd7UKWdaU1jBVb17iynL
    [config.yaml]
